nos86/caravantic/hardware/sim/a1_ingressi/spice.py

"""Helper minimale: scrive un netlist, lancia ngspice in batch, legge l'output wrdata."""
import os
import subprocess
import tempfile
import time

import numpy as np

NGSPICE = r"C:\Program Files (x86)\Spice64\bin\ngspice_con.exe"
HERE = os.path.dirname(os.path.abspath(__file__))
MODELS = os.path.join(HERE, "models.lib").replace("\\", "/")


def run(netlist_body, analysis, vectors, temp=25):
    """Esegue `analysis` e ritorna dict nome->array (prima colonna = asse x)."""
    with tempfile.TemporaryDirectory() as td:
        out = os.path.join(td, "out.txt").replace("\\", "/")
        cir = os.path.join(td, "c.cir")
        text = f"""* auto
.include "{MODELS}"
.options temp={temp} tnom=25 reltol=1e-4 abstol=1e-12 itl1=500 itl4=200 rshunt=1e10 method=gear
{netlist_body}
.control
set wr_singlescale
set wr_vecnames
{analysis}
wrdata {out} {' '.join(vectors)}
.endc
.end
"""
        with open(cir, "w") as f:
            f.write(text)
        t0 = time.time()
        p = subprocess.run([NGSPICE, "-b", cir], capture_output=True, text=True, timeout=300)
        print(f"  [{time.time()-t0:5.1f}s] {analysis} T={temp}", flush=True)
        if not os.path.exists(out):
            raise RuntimeError(p.stdout[-3000:] + p.stderr[-3000:])
        data = np.atleast_2d(np.loadtxt(out, skiprows=1))
        names = open(out).readline().split()
        return {n.lower(): data[:, i] for i, n in enumerate(names)}
