nos86/caravantic/(commit log)

2026-07-28 docs: added schematics requirements
2026-10-14 feat(input): Design input stage for optoisolated inputs
2026-10-19 docs(frd): piedinatura RJ45 del remote inverter misurata (IF-007, OPEN-02)
    Comune LED pin 2, verde pin 4, rosso pin 7, contatto 3-5; nessuna
    resistenza di limitazione nel remote. OPEN-02 ripreso, restano le
    misure lato inverter.
    Claude-Session: https://claude.ai/code/session_01BiiynXAza9qB544cqBSM2T
2026-10-19 docs(frd): contatto 3-5 del remote: 1,9 ohm in ON, aperto in OFF
    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
2026-10-19 docs(frd): resistenza dei puntali 0,1 ohm per il contatto 3-5
    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
2026-10-19 docs(frd): placeholder 0 ohm sul ramo di comando inverter (IF-007)
    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
